kvandis/www.kvand-is.com/images/operatorskaya-gcu-main.jpg

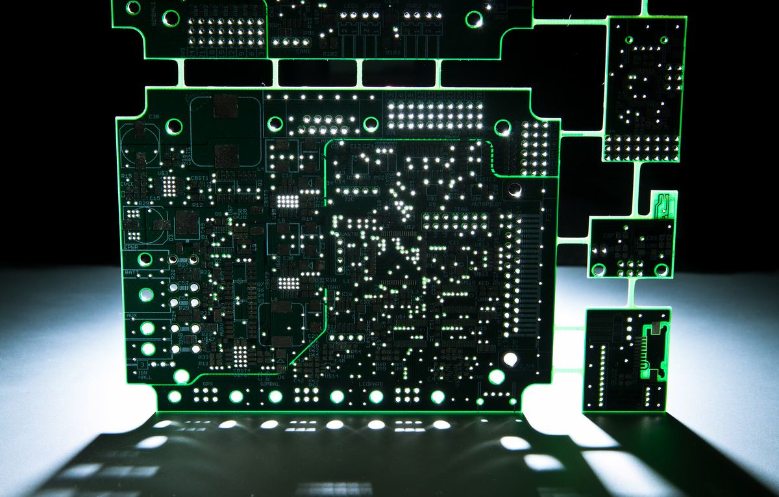
images/operatorskaya-gcu-main.jpg
