kvandis/www.kvand-is.com/images/2_i.jpg

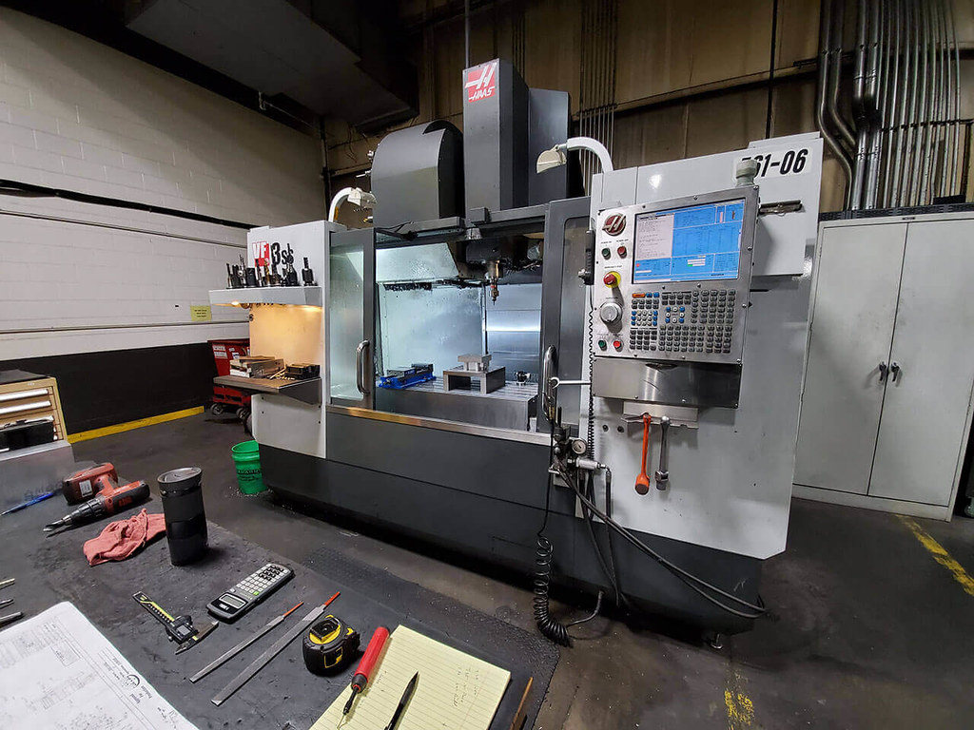
images/2_i.jpg
