kvandis/www.kvand-is.com/images/20143181351_f9261b28f0_c.jpg

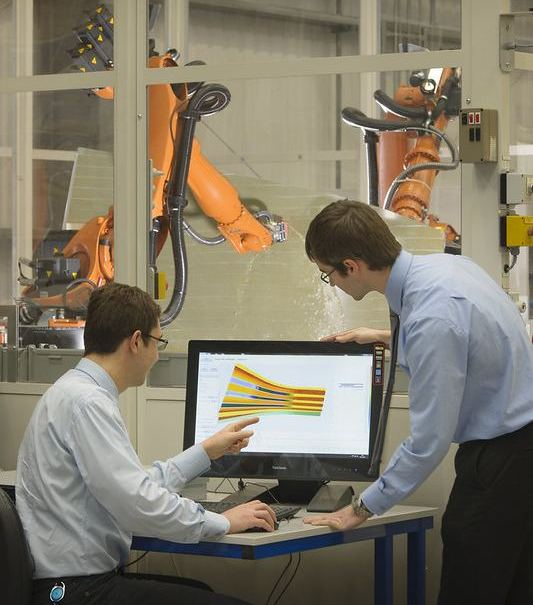
images/20143181351_f9261b28f0_c.jpg
