kvandis/www.kvand-is.com/images/49252277788_4cf0c296d2_h.jpg

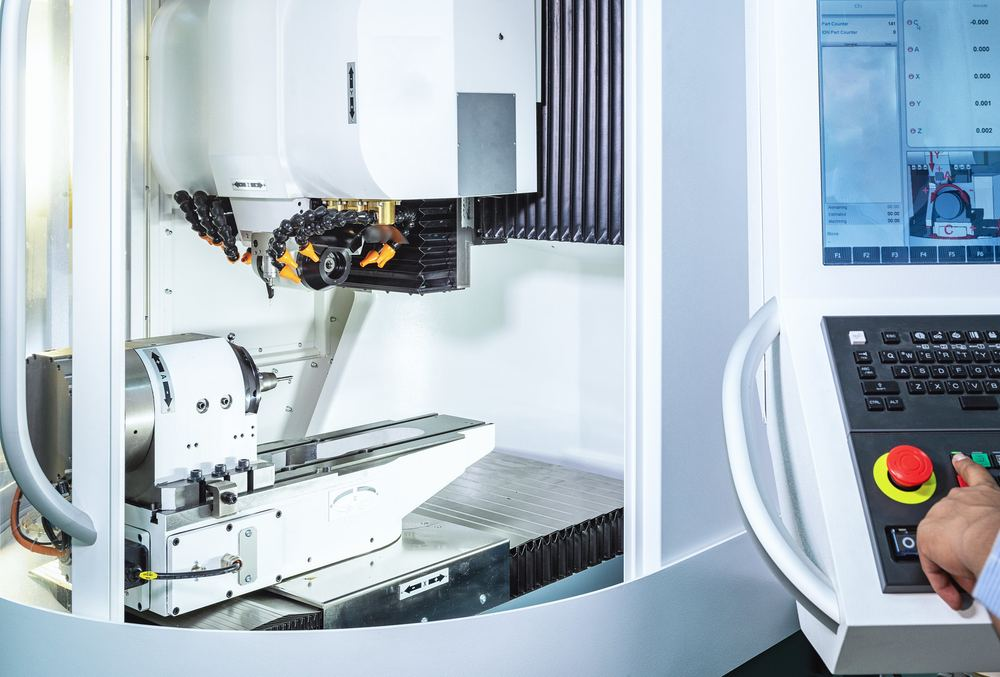
images/49252277788_4cf0c296d2_h.jpg
