kvandis/www.kvand-is.com/templates/ja_coach/images/decor/dots.png

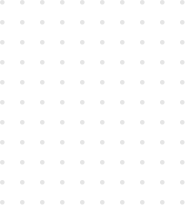
templates/ja_coach/images/decor/dots.png
