kvandis/www.kvand-is.com/templates/ja_coach/images/decor/item-2.png

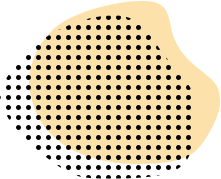
templates/ja_coach/images/decor/item-2.png
