kvandis/www.kvand-is.com/images/products/models/m_priemnik_vozdushnogo_davleniya_mini.STEP

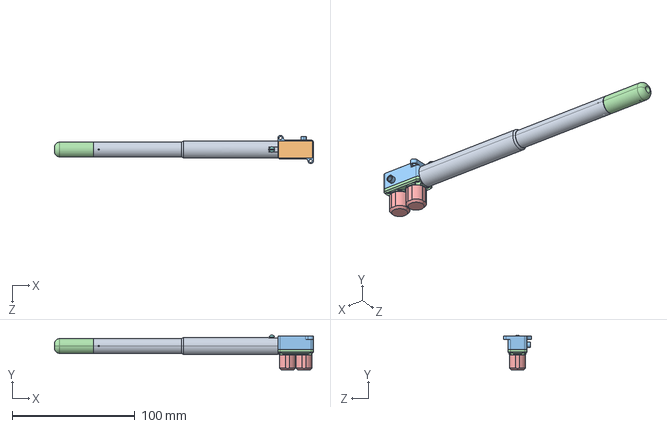
[picture p8: CAD file, 2022-05-05, last stored version]
images/products/models/m_priemnik_vozdushnogo_davleniya_mini.STEP
210.9 x 28.4 x 23.1 mm
