kvandis/www.kvand-is.com/images/products/models/m_blok_sku_bppd.STEP

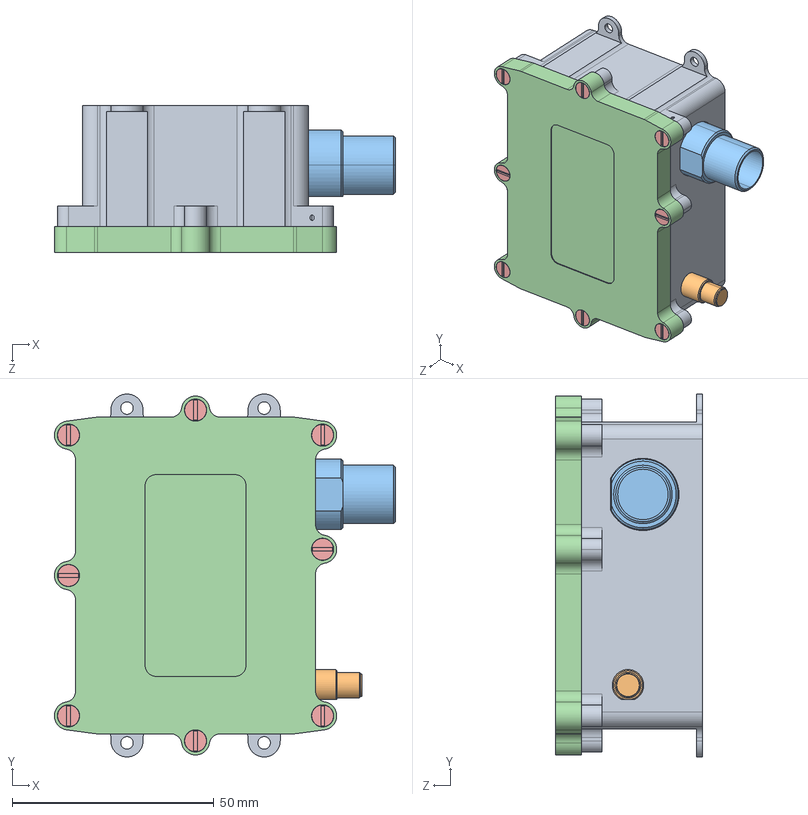
[picture p9: CAD file, 2022-05-05, last stored version]
images/products/models/m_blok_sku_bppd.STEP
84.6 x 90.0 x 36.5 mm
Îñí êîðïóñà ìîäåìà_2_01
冓踖樦 SMA
Êîðïóñ ÑÍÖ 29_8D7-09F35PN
署赅 祛溴爨 big_01
Áîëò ïîòàé_‚¨â ¯®â © 3-10 ¥à¦ x 8
