kvandis/www.kvand-is.com/images/products/models/m_antenna_bortovaya.STEP

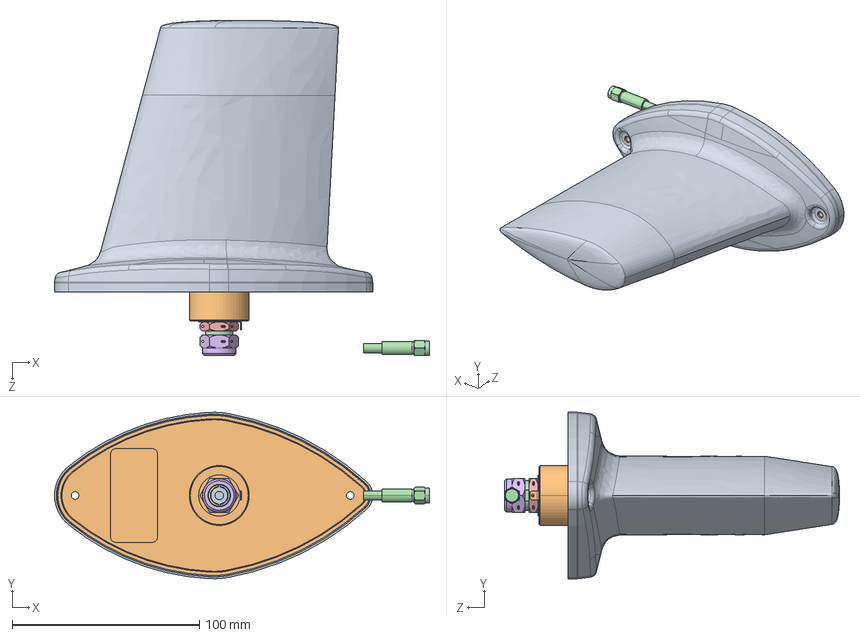
[picture p10: CAD file, 2022-05-05, last stored version]
images/products/models/m_antenna_bortovaya.STEP
200.3 x 89.0 x 179.0 mm
Êîðïóñ àíòåííû îáùèé_3work
Êîðïóñ àíòåííû îáùèé_3work_®á®¢ ¨¥
Ïðîêëàäêà àíòåííû AKL
ﾎ魵瑙韃 肄魵粽萵
ãàéêà ïðîìåæóòî÷íàÿ
ãàéêà òîðöåâàÿ
øàéáà ðàçðåçíàÿ
âòóëêà ðåçèíîâàÿ
Êîëüöî ñòîïîðíîå
暑朦鲱 箫腩蝽栩咫铄_14-17-19
Ðàçúåì SMA-Ì
