kvandis/www.kvand-is.com/images/products/models/m_blok_navigacii_bnpd_cphc.STEP

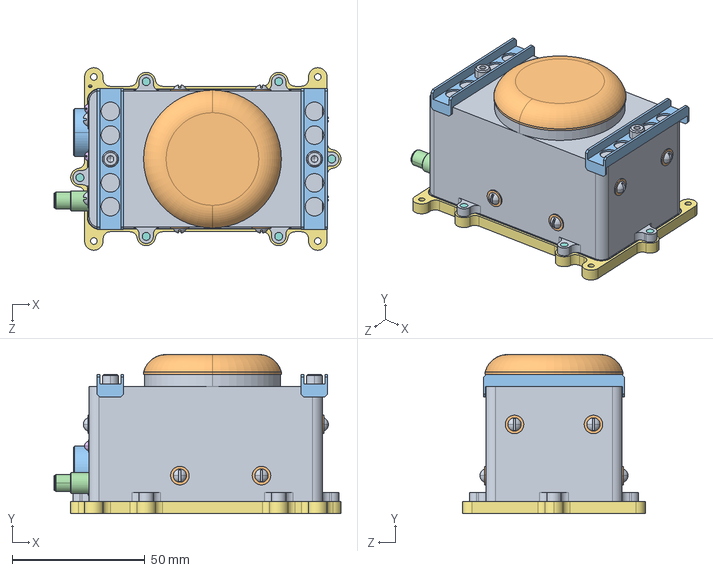
[picture p11: CAD file, 2022-05-05, last stored version]
images/products/models/m_blok_navigacii_bnpd_cphc.STEP
108.3 x 60.0 x 68.9 mm
