kvandis/www.kvand-is.com/images/products/models/m_blok_raschireniya.STEP

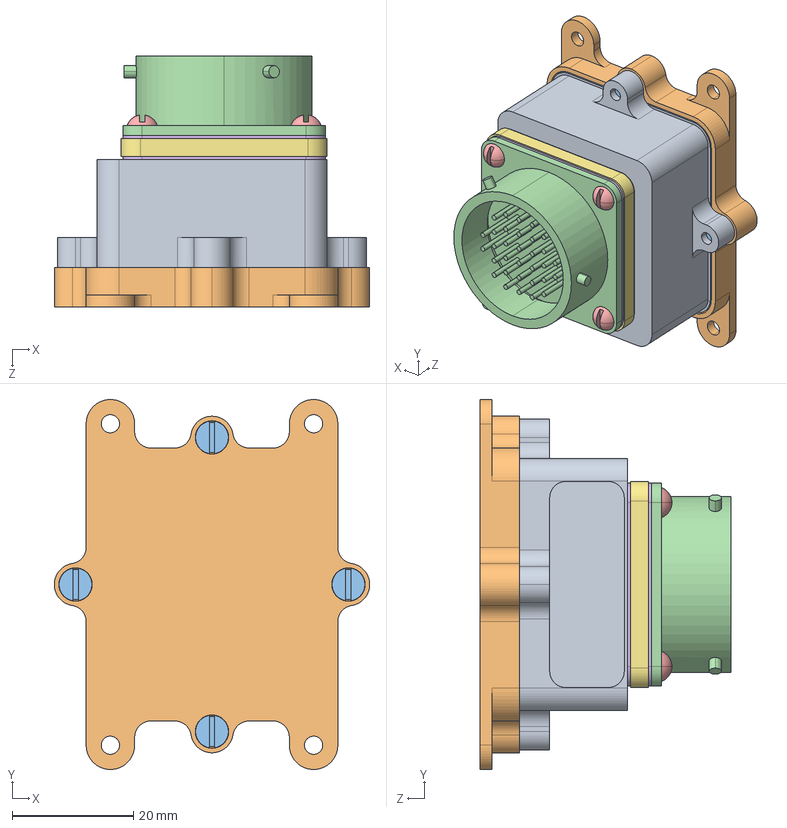
[picture p12: CAD file, 2022-05-05, last stored version]
images/products/models/m_blok_raschireniya.STEP
52.0 x 61.0 x 41.4 mm
暑痫篑 列_9.1
署赅 列_9.1_01
Áîëò ïîòàé_‚¨â ¯®â © 3-10 ¥à¦ x 4
����� ���28_���28-32_27
令腧 镱塍牮_偍  3-10 唳 x 4
�� ������� ���_���-32_27 x 2
����.431329.90.332.05_���-32_27
