kvandis/www.kvand-is.com/images/products/models/m_ses7.STEP

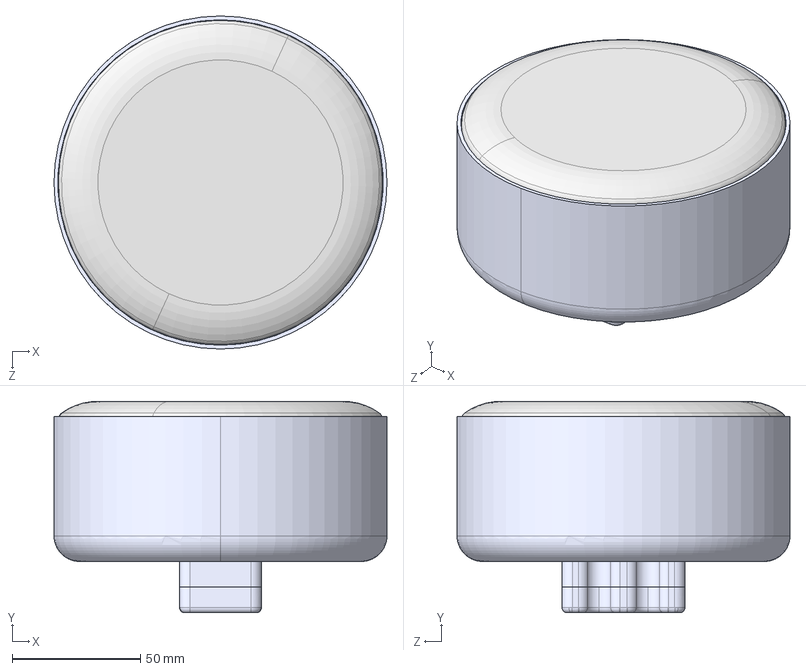
[picture p13: CAD file, 2022-05-05, last stored version]
images/products/models/m_ses7.STEP
130.0 x 82.5 x 130.0 mm
贈婝.7911.07.04 膰豵鵨
秘赞.7911.07.05 牮赅
贈婝.7911.07.01
贈婝.7911.07.02
