kvandis/www.kvand-is.com/images/products/models/m_skuva.STEP

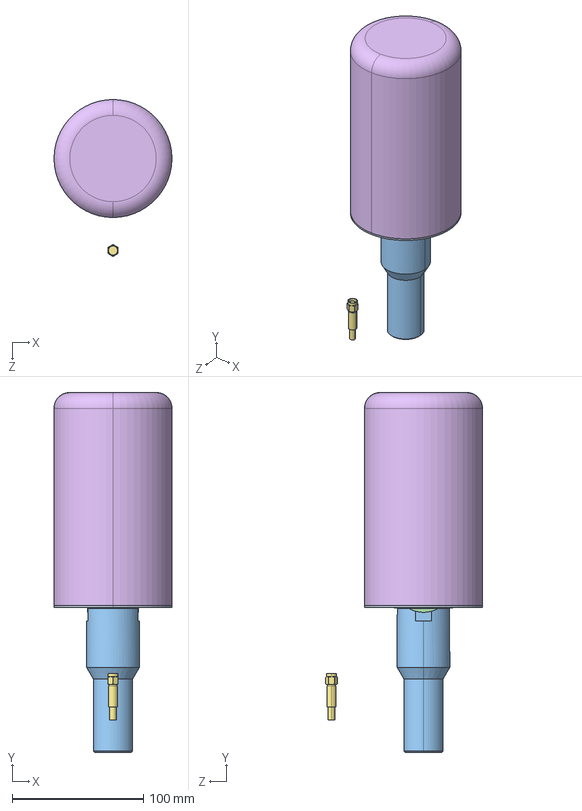
[picture p14: CAD file, 2022-05-05, last stored version]
images/products/models/m_skuva.STEP
89.8 x 274.0 x 119.5 mm
îñíîâàíèå êðåïåæíîå
ﾎ魵瑙韃 肄魵粽萵
ãàéêà ïðîìåæóòî÷íàÿ
ãàéêà òîðöåâàÿ
øàéáà ðàçðåçíàÿ
âòóëêà ðåçèíîâàÿ
Êîëüöî ñòîïîðíîå
暑朦鲱 箫腩蝽栩咫铄_14-17-19
Ïðîêëàäêà àíòåííû AKL
Êîíóñ ïåðåõîäíîé
ﾘ琺矜 ⅰⅱ浯
暑朦鲱 箫腩蝽栩咫铄_82-88-25
êîæóõ àíòåííû íàçåìíîé
Ðàçúåì SMA-Ì
