kvandis/www.kvand-is.com/images/products/models/m_priemnik_vozdushnogo_davleniya.STEP

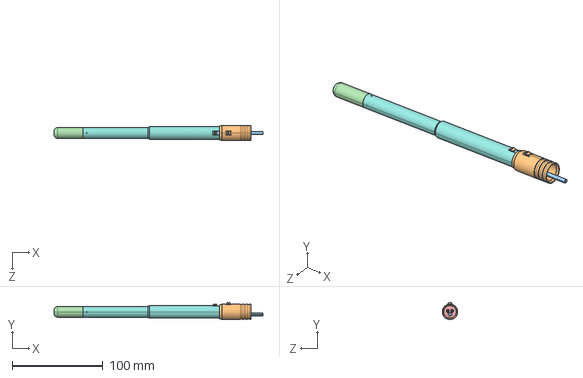
[picture p15: CAD file, 2022-05-05, last stored version]
images/products/models/m_priemnik_vozdushnogo_davleniya.STEP
229.8 x 18.9 x 17.0 mm
