kvandis/www.kvand-is.com/images/products/models/m_blok_cphc.STEP

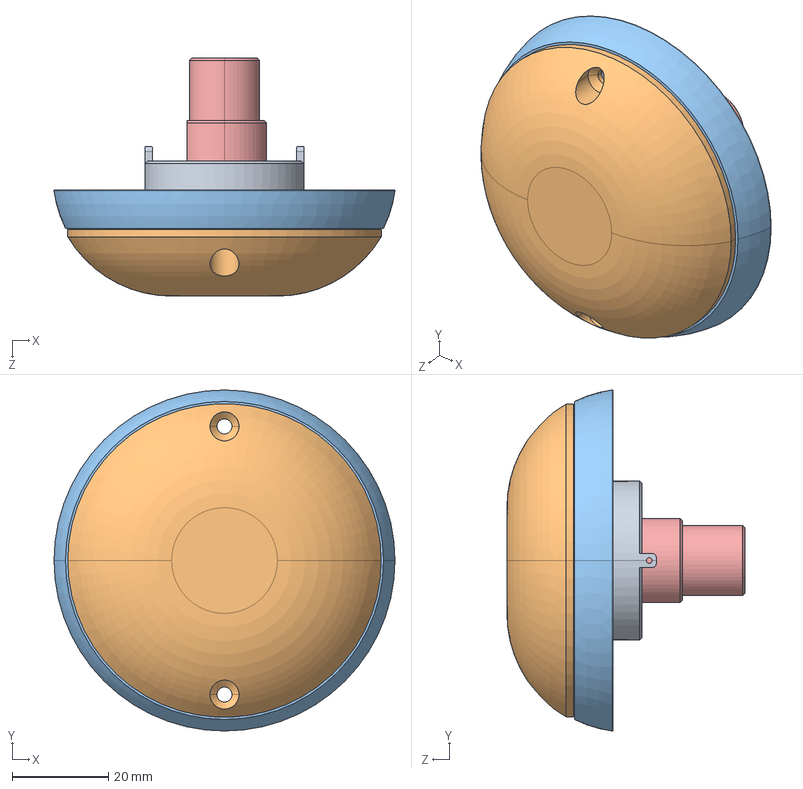
[picture p16: CAD file, 2022-05-05, last stored version]
images/products/models/m_blok_cphc.STEP
70.7 x 70.7 x 49.4 mm
ÃØÔÞ.431329.80.346.01-îñíîâàíèå
秘赞.431329.80.346.02-牮赅
ÃØÔÞ.431329.80.346.05-ïð ìîíòàæíàÿ
暑朦鲱 箫腩蝽栩咫铄_42-45-19
Êîðïóñ ÑÍÖ 29_8D7-09F35PN
