kvandis/www.kvand-is.com/images/products/models/m_ses25.STEP

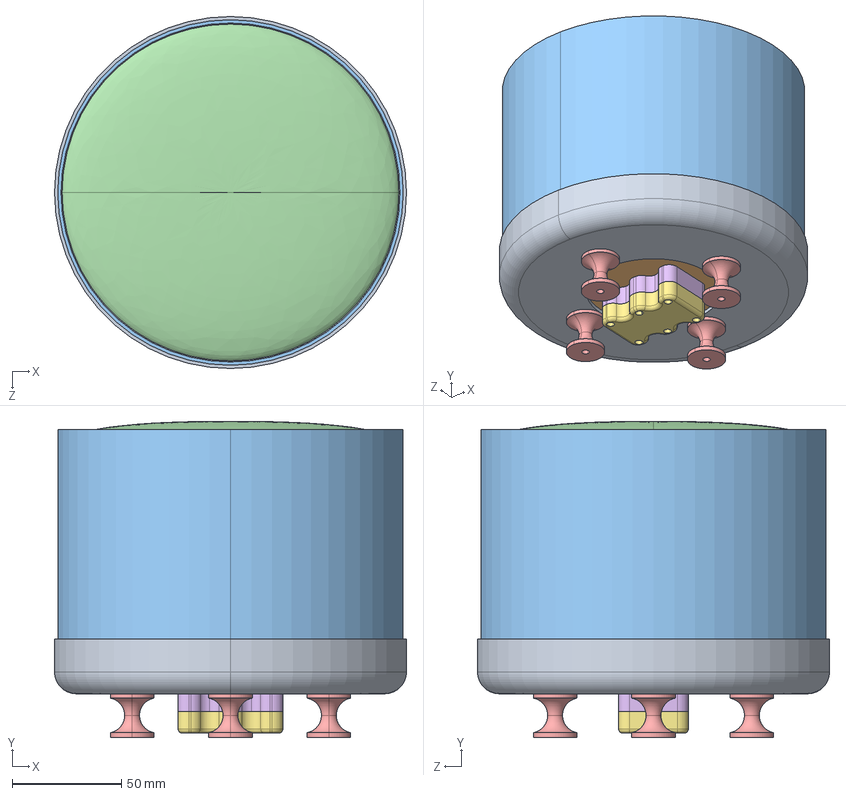
[picture p17: CAD file, 2022-05-05, last stored version]
images/products/models/m_ses25.STEP
161.0 x 144.6 x 161.0 mm
贈婝.7921.25.04
贈婝.7921.25.05
贈婝.7921.25.02
贈婝.7921.25.03
贈婝.7921.25.01 x 4
贈婝.7911.07.01
贈婝.7911.07.02
