kvandis/www.kvand-is.com/images/products/models/m_blok_bod_pwdm.STEP

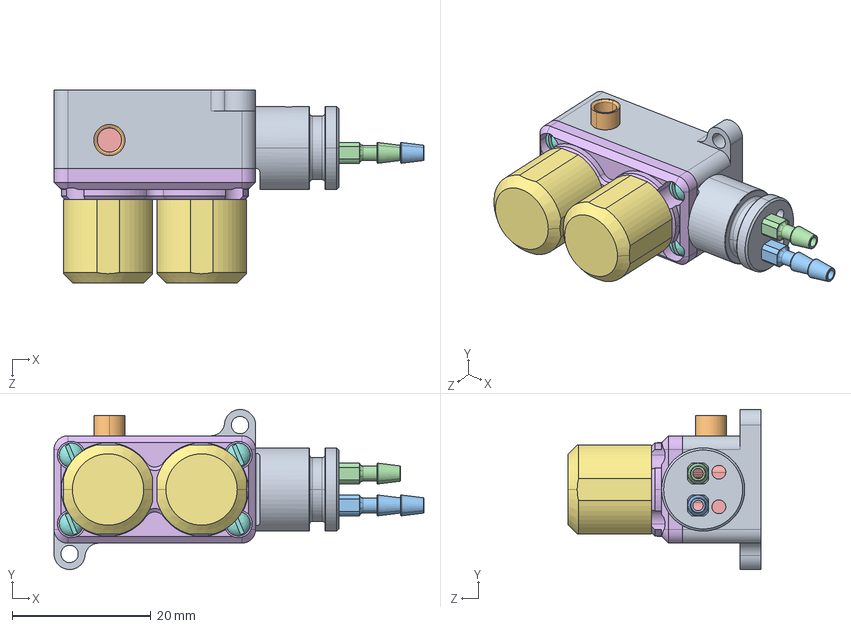
[picture p20: CAD file, 2022-05-05, last stored version]
images/products/models/m_blok_bod_pwdm.STEP
53.4 x 23.1 x 27.8 mm
暑痫篑 镫囹鸰3_03
âòóëêà ïîä ïðîâîäà_2
欙鼭歑_2_00
欙鼭歑_2_01
Çàïîëíèòåëü êîðïóñà_2_01
Êðûøêà ïðîìåæóòî÷íàÿ_2
Êîëáà êðûøêè_3 x 2
Âèíò 2-6-Ö-ÎÑÒ1 31529-80_‚¨â 2-4-–-Ž‘’1 31529-80 x 4
暑朦鲱 箫腩蝽栩咫铄_06-08-14 x 2
