kvandis/www.kvand-is.com/images/products/models/m_ultrazvukovoi_visotomer.STEP

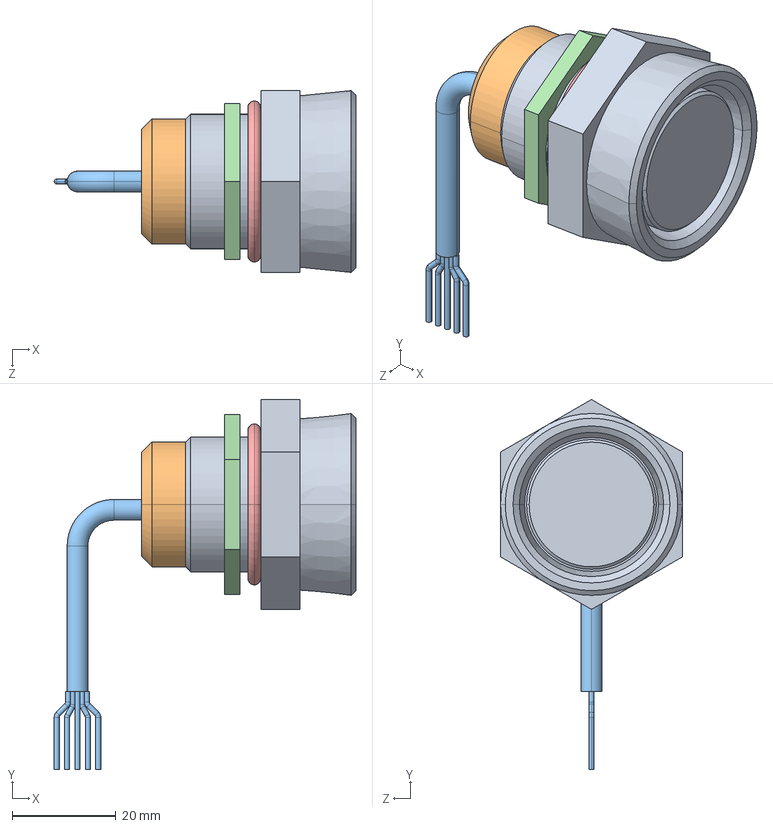
[picture p21: CAD file, 2022-05-05, last stored version]
images/products/models/m_ultrazvukovoi_visotomer.STEP
58.1 x 71.2 x 35.0 mm
ﾂ靏ⅳ黑褞 ﾓﾇ MB7068
Çàïîëíèòåëü ÓÇÂ
贈婝.431329.80.342.20
Ìîíòàæíûé êîìïëåêò
