kvandis/www.kvand-is.com/images/products/models/m_blok_obrabotki_dannih_pvd.STEP

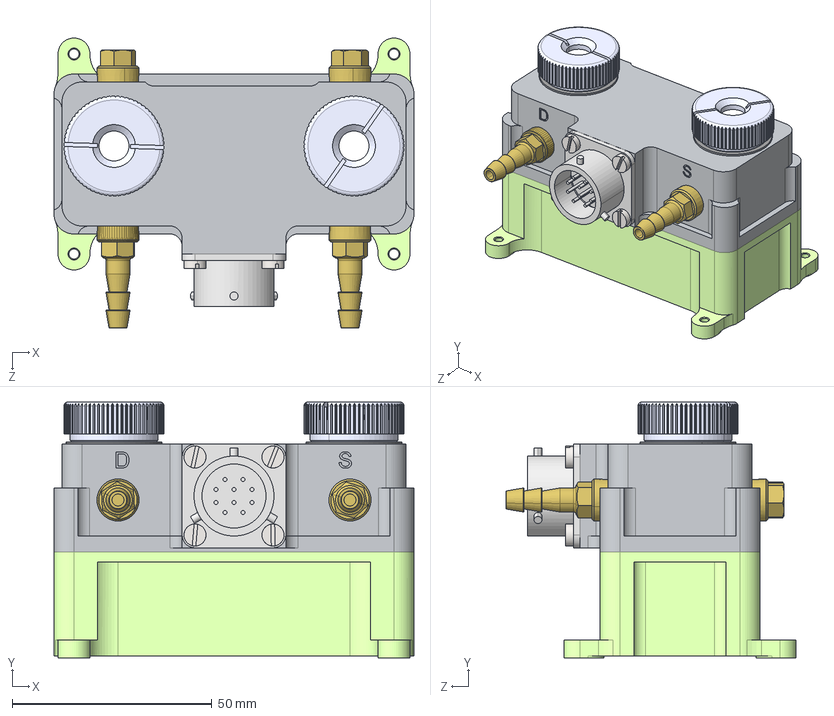
[picture p22: CAD file, 2022-05-05, last stored version]
images/products/models/m_blok_obrabotki_dannih_pvd.STEP
90.0 x 64.0 x 72.5 mm
